GT-IEEE-Robotics/2018/Electrical/Bill Of Materials (what's on the robot so far) - Spreadsheet.xlsx

ITEM | COUNT | PRICE | LINK
base wheel motors | 4 | 39.95 | https://www.pololu.com/product/2824
distance sensors | 8 | 14.94 | https://www.adafruit.com/product/3317
motor controller |  |  | http://www.robotshop.com/en/cytron-10a-5-25v-dual-channel-dc-motor-driver.html#Supplier-Product-Code
