GT-IEEE-Robotics/2018/Electrical/Pi_ExternalConnections.xlsx

Interface | Link | Count | Section | Signal Name | Signal Description | Connector | Link
Pi Breakout Interface | Pi Pinout (https://pinout.xyz/) | 1 |  | N/A | Interface to Pi &Breakout | 40-pins (2 rows of 20) extra long female headers | adafruit (https://www.adafruit.com/product/1979)
Arduino Interface |  |  | power |  |  | 4-pin female latched 0.1" header | digikey (https://www.digikey.com/products/en?keywords=WM4826-ND) | https://www.digikey.com/products/en?keywords=WM4825-ND
 |  |  |  | GND | ground from arduino
 |  |  | serial | Tx | Pi's transmit
 |  |  |  | Rx | Pi's receive
Distance Sensor | adafruit (https://learn.adafruit.com/adafruit-vl53l0x-micro-lidar-distance-sensor-breakout/pinouts) | 8 |  | Vin | input voltage (use 3.3V for our logic levels) | 5-pin snapping connector | digikey (http://www.digikey.com/scripts/DkSearch/dksus.dll?Detail&itemSeq=252199103&uq=636543209955835002) | https://www.digikey.com/products/en?keywords=WM4827-ND
 |  |  |  | GND | ground
 |  |  |  | SHDN | Shutdown(pull low to shutdown)
 |  |  |  | SCL | i2c serial clock
 |  |  |  | SDA | i2c serial data
5V Power from Voltage Regulator |  |  | power | PWR_5V | 5V power from arduino | 2-pin female latched 0.1" header |  | https://www.digikey.com/products/en?keywords=WM4824-ND
 |  |  |  | GND | ground from arduino
