GT-IEEE-Robotics/2018/Electrical/Arduino_ExternalConnections.xlsx

Interface | Link | Count | Section | Signal Name | Signal Description | Connector | Link | Count
Arduino Due Shield Interface | due (https://store.arduino.cc/usa/arduino-due) | 1 |  |  |  | 8-pin extra long female headers | sparkfun (https://www.sparkfun.com/products/9279) | 5
 | pinout (http://www.robgray.com/temp/Due-pinout-WEB.png) |  |  |  |  | 10-pin " | sparkfun (https://www.sparkfun.com/products/11376) | 4
 |  |  |  |  |  | 2 row 3 pins (for SPI) | sparkfun (https://www.sparkfun.com/products/13010) | 1
 |  |  |  |  |  | 2 rows of 18 " (buy the 2 pack of 20 & cut) | sparkfun (https://www.sparkfun.com/products/14311) | 1
Battery Power |  | 1 |  | B_PWR | Battery Power (12V) | 2-pin 0.295" blade connector (rated to 18A) | digikey (https://www.digikey.com/product-detail/en/molex-llc/0431602102/WM18478-ND/300111)
 |  |  |  | B_GND | Battery Ground | *note: use 16-gauge wire(18 A)
Fuse(12V,30A) | digikey (https://www.digikey.com/product-detail/en/eaton/BK-AGC-30-R/283-2633-ND/954181) | 1 |  | from_battery |  | holder (use 2 of these) | digikey (https://www.digikey.com/product-detail/en/eaton/BK-1A1907-06-R/283-2601-ND/954119)
 |  |  |  | out_of_fuse
Pi Interface |  | 1 | power | PWR_5V | 5V to power the Pi (pin 2) | 4-pin female latched 0.1" header | digikey (https://www.digikey.com/products/en?keywords=WM4826-ND)
 |  |  |  | GND | Ground for Pi (pin 6)
 |  |  | serial | Rx | Arduino's Receive (connect to Pi's Tx)
 |  |  |  | Tx | Arduino's Transmit (connect to Pi's Rx)
Motor & Encoder | pololu (https://www.pololu.com/product/2824) | 6 |  | Red | Motor Power (from motor controller) | 6-pin female latched header | digikey (https://www.digikey.com/product-detail/en/molex-connector-corporation/0705430040/WM4828-ND/313743)
 |  |  |  | Black | Motor Ground (from motor controller)
 |  |  |  | Green | encoder ground
 |  |  |  | Blue | encoder power (5V)
 |  |  |  | Yellow | encoder out A
 |  |  |  | White | encoder out B
Dual-Motor Controller | robotshop (http://www.robotshop.com/en/cytron-10a-5-25v-dual-channel-dc-motor-driver.html) | 3 | control signals | M1 dir | motor 1 direction | 5-pin female header | (comes with)
 |  |  |  | M1 pwm | motor 1 speed
 |  |  |  | M2 dir | motor 2 direction
 |  |  |  | M2 pwm | motor 2 speed
 |  |  |  | GND | ground
 |  |  | power | M1B | motor 1 ground | .2" spaced pluggable terminal block | digikey (https://www.digikey.com/products/en?keywords=277-1110-ND)
 |  |  |  | M1A | motor 1 power | plug | digikey (https://www.digikey.com/product-detail/en/phoenix-contact/1757051/277-1015-ND/260383)
 |  |  |  | B+ | Battery Power (12V)
 |  |  |  | B- | Battery Ground
 |  |  |  | M2A | motor 2 power
 |  |  |  | M2B | motor 2 ground
Level Shifters | sparkfun (https://www.sparkfun.com/products/12009) | 3 | row 1 | HV1 | high voltage 1 | 6 pin 0.1" female header | digikey (https://www.digikey.com/product-detail/en/sullins-connector-solutions/PPTC061LFBN-RC/S7004-ND/810145)
 |  |  |  | HV2 | high voltage 2
 |  |  |  | HV | high voltage supply
 |  |  |  | GND | ground
 |  |  |  | HV3 | high voltage 3
 |  |  |  | HV4 | high voltage 4
 |  |  | row 2 | LV1 | low voltage 1 | 6 pin 0.1" female header | "
 |  |  |  | LV2 | low voltage 2
 |  |  |  | LV | low voltage supply
 |  |  |  | GND | ground
 |  |  |  | LV3 | low voltage 3
 |  |  |  | LV4 | low voltage 4
IMU | sparkfun (https://www.sparkfun.com/products/13284) | 1 | left | GND | ground | 0.1" standard header pins | digikey (https://www.digikey.com/products/en?mpart=PRPC040SACN-RC&v=35)
 |  |  |  | VDD/VCC | power (3.3V) | (only using this header)
 |  |  |  | SDA | i2c SDA OR SPI: MOSI
 |  |  |  | SCL | i2c & SPI serial clock
 |  |  | right | DEN | gyroscope data enable | 0.1" standard header pins | digikey (https://www.digikey.com/products/en?mpart=PRPC040SACN-RC&v=35)
 |  |  |  | INT1 | accel/gyro interrupt 1
 |  |  |  | INT2 | accel/gyro interrupt 2
 |  |  |  | INTM | magnetometer interrupt
 |  |  |  | RDY | magnetometer data ready
 |  |  |  | CS M | magnetometer chip select
 |  |  |  | CS AG | Accel/Gyro chip select
 |  |  |  | SDO M | SPI: Magnetometer MISO, I2C: Magnetometer Address Select
 |  |  |  | SDO AG | SPI: Accel/Gyro MISO, I2C: Accel/Gryo Address Select
