GT-IEEE-Robotics/2018/Electrical/MotorCape_hierchal/MotorCape.kicad_pcb

## KiCad design Electrical/MotorCape_hierchal/MotorCape.kicad_pcb (2018-04-20)

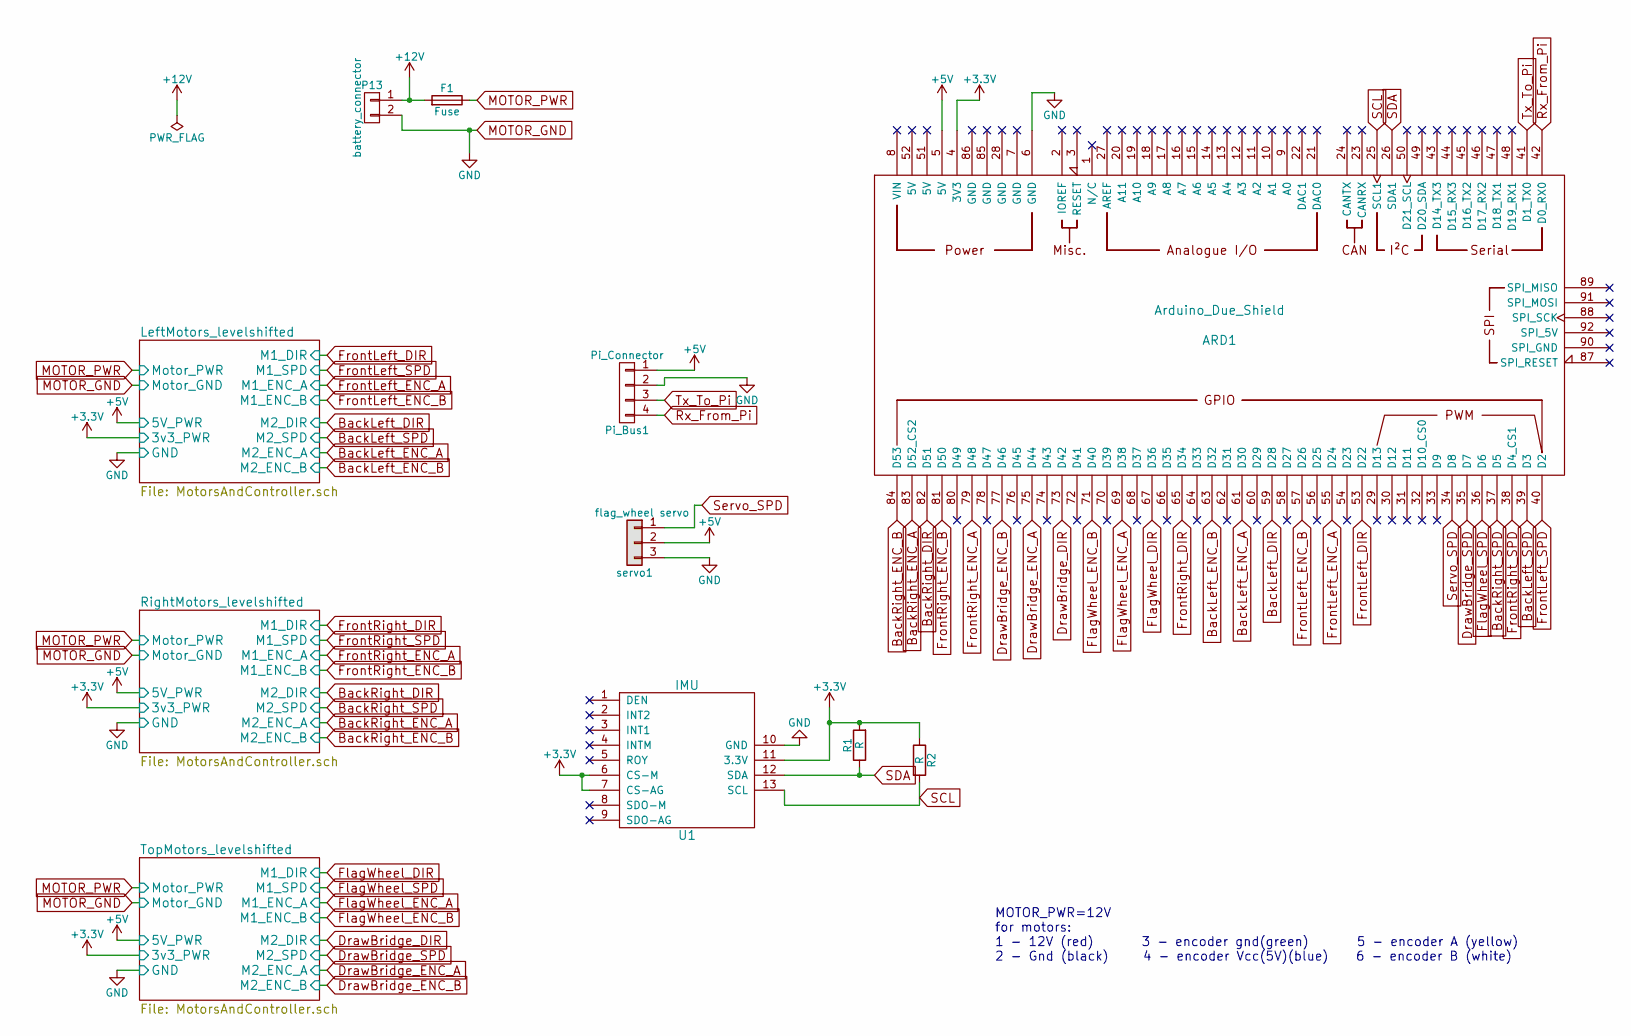
[picture p1: schematic MotorCape.sch]

Parts:
ARD1: Arduino_Due_Shield
F1: Fuse; Fuseholder_horizontal_inline_1_25x0_25_inch
P13: battery_connector; Molex_Sabre_43160-XX02_02x7.49mm_Vertical_BoardLock
Pi_Bus1: Pi_Connector; Pin_Header_Latched_1x04
R1, R2: R; R_Axial_DIN0204_L3.6mm_D1.6mm_P5.08mm_Horizontal
U1: IMU
servo1: flag_wheel servo; Pin_Header_Latched_1x03

Connections:
+3V3: ARD1.4 (3V3), R1.2, R2.1, U1.6 (CS-M), U1.7 (CS-AG), U1.11 (3.3V); also elsewhere on the board
+5V: ARD1.5 (5V), Pi_Bus1.1, servo1.2; also elsewhere on the board
+12V: F1.2, P13.1
BackLeft_DIR: ARD1.59 (D28); also elsewhere on the board
BackLeft_ENC_A: ARD1.61 (D30); also elsewhere on the board
BackLeft_ENC_B: ARD1.63 (D32); also elsewhere on the board
BackLeft_SPD: ARD1.39 (D3); also elsewhere on the board
BackRight_DIR: ARD1.82 (D51); also elsewhere on the board
BackRight_ENC_A: ARD1.83 (D52_CS2); also elsewhere on the board
BackRight_ENC_B: ARD1.84 (D53); also elsewhere on the board
BackRight_SPD: ARD1.37 (D5); also elsewhere on the board
DrawBridge_DIR: ARD1.73 (D42); also elsewhere on the board
DrawBridge_ENC_A: ARD1.75 (D44); also elsewhere on the board
DrawBridge_ENC_B: ARD1.77 (D46); also elsewhere on the board
DrawBridge_SPD: ARD1.35 (D7); also elsewhere on the board
FlagWheel_DIR: ARD1.67 (D36); also elsewhere on the board
FlagWheel_ENC_A: ARD1.69 (D38); also elsewhere on the board
FlagWheel_ENC_B: ARD1.71 (D40); also elsewhere on the board
FlagWheel_SPD: ARD1.36 (D6); also elsewhere on the board
FrontLeft_DIR: ARD1.53 (D22); also elsewhere on the board
FrontLeft_ENC_A: ARD1.55 (D24); also elsewhere on the board
FrontLeft_ENC_B: ARD1.57 (D26); also elsewhere on the board
FrontLeft_SPD: ARD1.40 (D2); also elsewhere on the board
FrontRight_DIR: ARD1.65 (D34); also elsewhere on the board
FrontRight_ENC_A: ARD1.79 (D48); also elsewhere on the board
FrontRight_ENC_B: ARD1.81 (D50); also elsewhere on the board
FrontRight_SPD: ARD1.38 (D4_CS1); also elsewhere on the board
MOTOR_GND: ARD1.6 (GND), P13.2, Pi_Bus1.2, U1.10 (GND), servo1.3; also elsewhere on the board
MOTOR_PWR: F1.1; also elsewhere on the board
Rx_From_Pi: ARD1.42 (D0_RX0), Pi_Bus1.4
SCL: ARD1.25 (SCL1), R2.2, U1.13 (SCL)
SDA: ARD1.26 (SDA1), R1.1, U1.12 (SDA)
Servo_SPD: ARD1.34 (D8), servo1.1
Tx_To_Pi: ARD1.41 (D1_TX0), Pi_Bus1.3

Notes on the sheet:
MOTOR_PWR=12V for motors: 1 - 12V (red) 3 - encoder gnd(green) 5 - encoder A (yellow) 2 - Gnd (black) 4 - encoder Vcc(5V)(blue) 6 - encoder B (white)

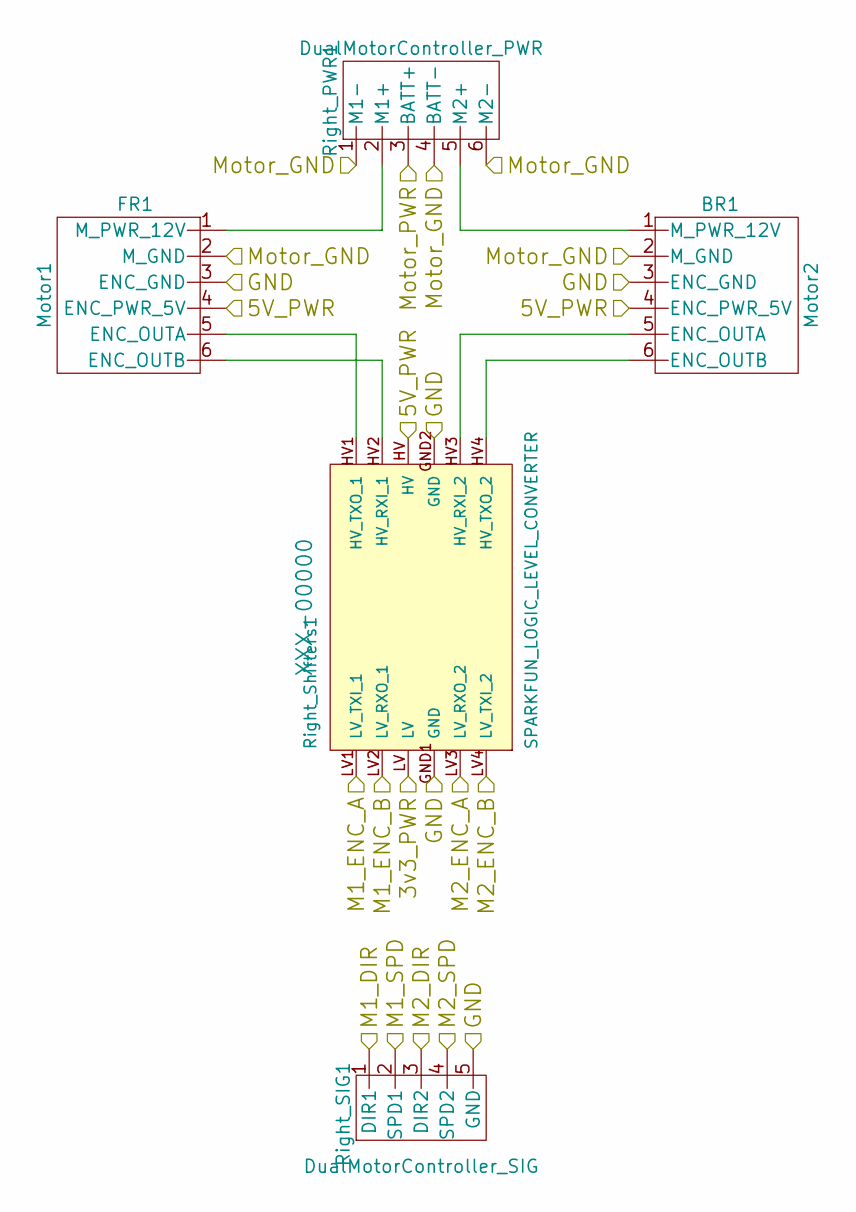
[picture p2: schematic MotorsAndController.sch]

Parts:
BL1: Motor2; Pin_Header_Latched_1x06
FL1: Motor1; Pin_Header_Latched_1x06
Left_PWR1: DualMotorController_PWR; PhoenixContact_MSTBA-G_06x5.08mm_Angled
Left_SIG1: DualMotorController_SIG; Pin_Header_Latched_1x05
Left_Shifters1: SPARKFUN_LOGIC_LEVEL_CONVERTER

Connections:
+3V3: Left_Shifters1.LV; also elsewhere on the board
+5V: BL1.4 (ENC_PWR_5V), FL1.4 (ENC_PWR_5V), Left_Shifters1.HV; also elsewhere on the board
BackLeft_DIR: Left_SIG1.3 (DIR2); also elsewhere on the board
BackLeft_ENC_A: Left_Shifters1.LV3 (LV_RXO_2); also elsewhere on the board
BackLeft_ENC_B: Left_Shifters1.LV4 (LV_TXI_2); also elsewhere on the board
BackLeft_SPD: Left_SIG1.4 (SPD2); also elsewhere on the board
FrontLeft_DIR: Left_SIG1.1 (DIR1); also elsewhere on the board
FrontLeft_ENC_A: Left_Shifters1.LV1 (LV_TXI_1); also elsewhere on the board
FrontLeft_ENC_B: Left_Shifters1.LV2 (LV_RXO_1); also elsewhere on the board
FrontLeft_SPD: Left_SIG1.2 (SPD1); also elsewhere on the board
MOTOR_GND: BL1.2 (M_GND), BL1.3 (ENC_GND), FL1.2 (M_GND), FL1.3 (ENC_GND), Left_PWR1.1 (M1-), Left_PWR1.4 (BATT-), Left_PWR1.6 (M2-), Left_SIG1.5 (GND), Left_Shifters1.GND1 (GND), Left_Shifters1.GND2 (GND); also elsewhere on the board
MOTOR_PWR: Left_PWR1.3 (BATT+); also elsewhere on the board
unnamed: BL1.1 (M_PWR_12V), Left_PWR1.5 (M2+)
unnamed: BL1.5 (ENC_OUTA), Left_Shifters1.HV3 (HV_RXI_2)
unnamed: BL1.6 (ENC_OUTB), Left_Shifters1.HV4 (HV_TXO_2)
unnamed: FL1.1 (M_PWR_12V), Left_PWR1.2 (M1+)
unnamed: FL1.5 (ENC_OUTA), Left_Shifters1.HV1 (HV_TXO_1)
unnamed: FL1.6 (ENC_OUTB), Left_Shifters1.HV2 (HV_RXI_1)

Parts of its further copies:
BR1: Motor2; Pin_Header_Latched_1x06
DrawBridge1: Motor2; Pin_Header_Latched_1x06
FR1: Motor1; Pin_Header_Latched_1x06
FlagWheel1: Motor1; Pin_Header_Latched_1x06
Right_PWR1: DualMotorController_PWR; PhoenixContact_MSTBA-G_06x5.08mm_Angled
Right_SIG1: DualMotorController_SIG; Pin_Header_Latched_1x05
Right_Shifters1: SPARKFUN_LOGIC_LEVEL_CONVERTER
Top_PWR1: DualMotorController_PWR; PhoenixContact_MSTBA-G_06x5.08mm_Angled
Top_SIG1: DualMotorController_SIG; Pin_Header_Latched_1x05
Top_Shifters1: SPARKFUN_LOGIC_LEVEL_CONVERTER

Connections of its further copies:
+3V3: Right_Shifters1.LV, Top_Shifters1.LV; also elsewhere on the board
+5V: BR1.4 (ENC_PWR_5V), DrawBridge1.4 (ENC_PWR_5V), FR1.4 (ENC_PWR_5V), FlagWheel1.4 (ENC_PWR_5V), Right_Shifters1.HV, Top_Shifters1.HV; also elsewhere on the board
BackRight_DIR: Right_SIG1.3 (DIR2); also elsewhere on the board
BackRight_ENC_A: Right_Shifters1.LV3 (LV_RXO_2); also elsewhere on the board
BackRight_ENC_B: Right_Shifters1.LV4 (LV_TXI_2); also elsewhere on the board
BackRight_SPD: Right_SIG1.4 (SPD2); also elsewhere on the board
DrawBridge_DIR: Top_SIG1.3 (DIR2); also elsewhere on the board
DrawBridge_ENC_A: Top_Shifters1.LV3 (LV_RXO_2); also elsewhere on the board
DrawBridge_ENC_B: Top_Shifters1.LV4 (LV_TXI_2); also elsewhere on the board
DrawBridge_SPD: Top_SIG1.4 (SPD2); also elsewhere on the board
FlagWheel_DIR: Top_SIG1.1 (DIR1); also elsewhere on the board
FlagWheel_ENC_A: Top_Shifters1.LV1 (LV_TXI_1); also elsewhere on the board
FlagWheel_ENC_B: Top_Shifters1.LV2 (LV_RXO_1); also elsewhere on the board
FlagWheel_SPD: Top_SIG1.2 (SPD1); also elsewhere on the board
FrontRight_DIR: Right_SIG1.1 (DIR1); also elsewhere on the board
FrontRight_ENC_A: Right_Shifters1.LV1 (LV_TXI_1); also elsewhere on the board
FrontRight_ENC_B: Right_Shifters1.LV2 (LV_RXO_1); also elsewhere on the board
FrontRight_SPD: Right_SIG1.2 (SPD1); also elsewhere on the board
MOTOR_GND: BR1.2 (M_GND), BR1.3 (ENC_GND), DrawBridge1.2 (M_GND), DrawBridge1.3 (ENC_GND), FR1.2 (M_GND), FR1.3 (ENC_GND), FlagWheel1.2 (M_GND), FlagWheel1.3 (ENC_GND), Right_PWR1.1 (M1-), Right_PWR1.4 (BATT-), Right_PWR1.6 (M2-), Right_SIG1.5 (GND), Right_Shifters1.GND1 (GND), Right_Shifters1.GND2 (GND), Top_PWR1.1 (M1-), Top_PWR1.4 (BATT-), Top_PWR1.6 (M2-), Top_SIG1.5 (GND), Top_Shifters1.GND1 (GND), Top_Shifters1.GND2 (GND); also elsewhere on the board
MOTOR_PWR: Right_PWR1.3 (BATT+), Top_PWR1.3 (BATT+); also elsewhere on the board
unnamed: BR1.1 (M_PWR_12V), Right_PWR1.5 (M2+)
unnamed: BR1.5 (ENC_OUTA), Right_Shifters1.HV3 (HV_RXI_2)
unnamed: BR1.6 (ENC_OUTB), Right_Shifters1.HV4 (HV_TXO_2)
unnamed: DrawBridge1.1 (M_PWR_12V), Top_PWR1.5 (M2+)
unnamed: DrawBridge1.5 (ENC_OUTA), Top_Shifters1.HV3 (HV_RXI_2)
unnamed: DrawBridge1.6 (ENC_OUTB), Top_Shifters1.HV4 (HV_TXO_2)
unnamed: FR1.1 (M_PWR_12V), Right_PWR1.2 (M1+)
unnamed: FR1.5 (ENC_OUTA), Right_Shifters1.HV1 (HV_TXO_1)
unnamed: FR1.6 (ENC_OUTB), Right_Shifters1.HV2 (HV_RXI_1)
unnamed: FlagWheel1.1 (M_PWR_12V), Top_PWR1.2 (M1+)
unnamed: FlagWheel1.5 (ENC_OUTA), Top_Shifters1.HV1 (HV_TXO_1)
unnamed: FlagWheel1.6 (ENC_OUTB), Top_Shifters1.HV2 (HV_RXI_1)

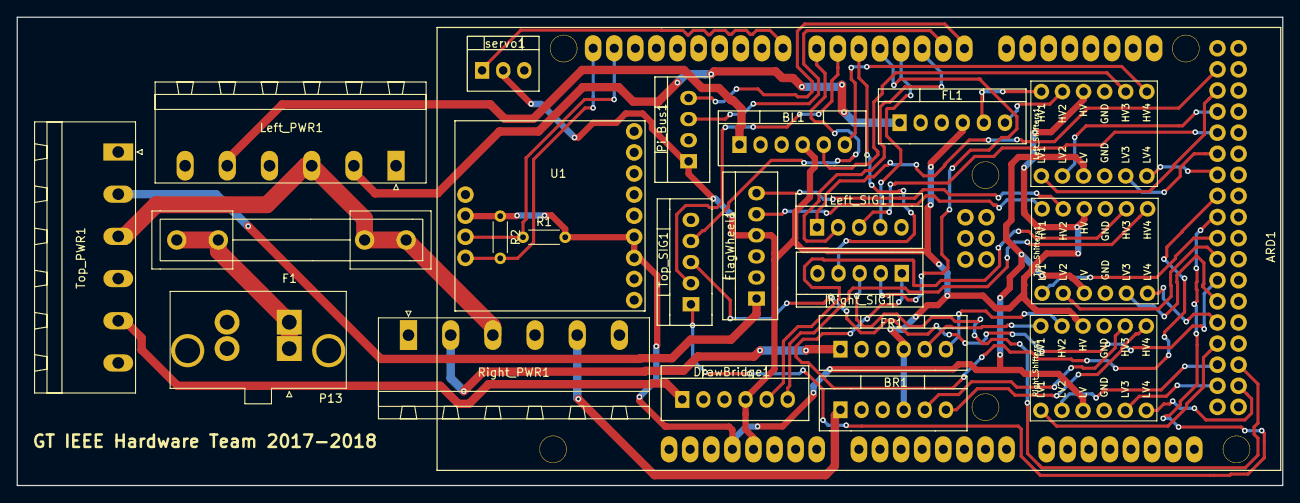
[picture p3: board Electrical/MotorCape_hierchal/MotorCape.kicad_pcb from above]

Board: 2 copper layers, 152.4 x 56.4 mm, 23 parts (0 on the bottom side), 52 nets.
