GT-IEEE-Robotics/2018/Electrical/Pi Cape/PI_Cape.kicad_pcb

## KiCad design Electrical/Pi Cape/PI_Cape.kicad_pcb (2018-04-20)

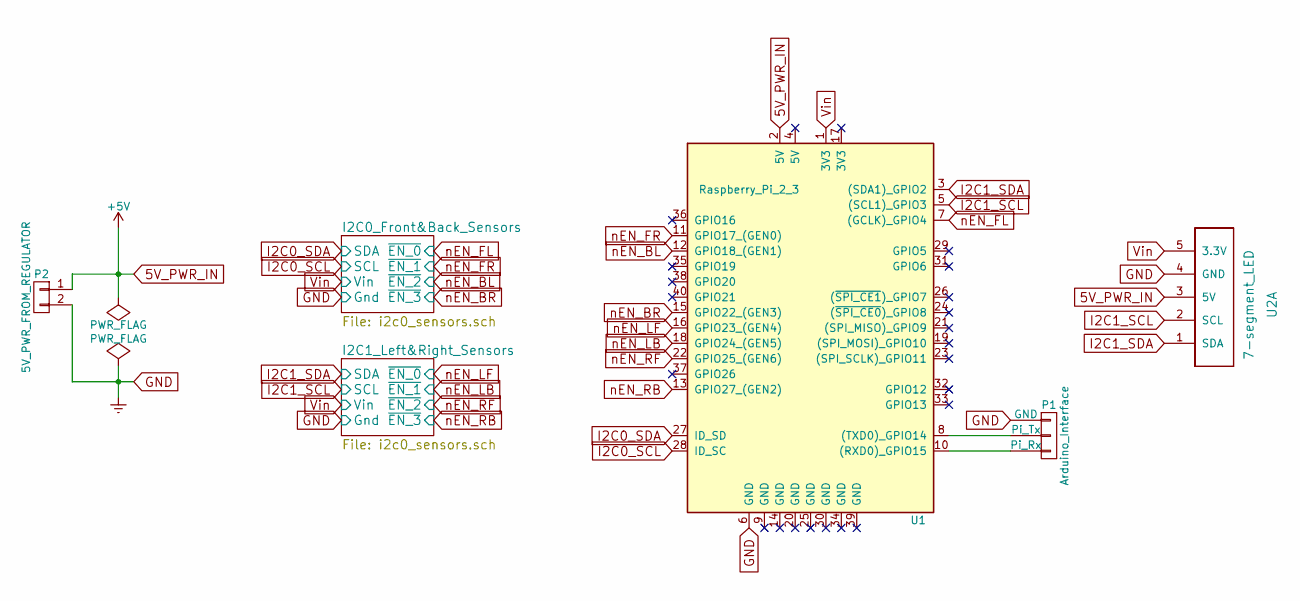
[picture p4: schematic PI_Cape.sch]

Parts:
P1: Arduino_Interface; Pin_Header_Latched_1x03
P2: 5V_PWR_FROM_REGULATOR; Pin_Header_Latched_1x02
U1: Raspberry_Pi_2_3; Pin_Header_Straight_2x20
U2: 7-segment_LED; Pin_Header_Straight_1x05

Connections:
5V_PWR_IN: P2.1, U1.2 (5V), U2.3 (5V)
GND: P1.1 (GND), P2.2, U1.6 (GND), U2.4 (GND); also elsewhere on the board
I2C0_SCL: U1.28 (ID_SC); also elsewhere on the board
I2C0_SDA: U1.27 (ID_SD); also elsewhere on the board
I2C1_SCL: U1.5 ((SCL1)_GPIO3), U2.2 (SCL); also elsewhere on the board
I2C1_SDA: U1.3 ((SDA1)_GPIO2), U2.1 (SDA); also elsewhere on the board
unnamed: P1.2 (Pi_Tx), U1.8 ((TXD0)_GPIO14)
unnamed: P1.3 (Pi_Rx), U1.10 ((RXD0)_GPIO15)
Vin: U1.1 (3V3), U2.5 (3.3V); also elsewhere on the board
nEN_BL: U1.12 (GPIO18_(GEN1)); also elsewhere on the board
nEN_BR: U1.15 (GPIO22_(GEN3)); also elsewhere on the board
nEN_FL: U1.7 ((GCLK)_GPIO4); also elsewhere on the board
nEN_FR: U1.11 (GPIO17_(GEN0)); also elsewhere on the board
nEN_LB: U1.18 (GPIO24_(GEN5)); also elsewhere on the board
nEN_LF: U1.16 (GPIO23_(GEN4)); also elsewhere on the board
nEN_RB: U1.13 (GPIO27_(GEN2)); also elsewhere on the board
nEN_RF: U1.22 (GPIO25_(GEN6)); also elsewhere on the board

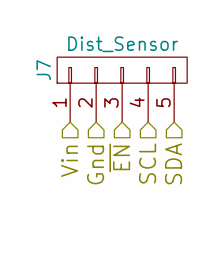
[picture p5: schematic i2c0.sch]

Parts:
J1: Dist_Sensor; Pin_Header_Latched_1x05

Connections:
GND: J1.2; also elsewhere on the board
I2C0_SCL: J1.4; also elsewhere on the board
I2C0_SDA: J1.5; also elsewhere on the board
Vin: J1.1; also elsewhere on the board
nEN_FL: J1.3; also elsewhere on the board

Parts of its further copies:
J2, J3, J4, J5, J6, J7, J8: Dist_Sensor; Pin_Header_Latched_1x05

Connections of its further copies:
GND: J2.2, J3.2, J4.2, J5.2, J6.2, J7.2, J8.2; also elsewhere on the board
I2C0_SCL: J2.4, J3.4, J4.4; also elsewhere on the board
I2C0_SDA: J2.5, J3.5, J4.5; also elsewhere on the board
I2C1_SCL: J5.4, J6.4, J7.4, J8.4; also elsewhere on the board
I2C1_SDA: J5.5, J6.5, J7.5, J8.5; also elsewhere on the board
Vin: J2.1, J3.1, J4.1, J5.1, J6.1, J7.1, J8.1; also elsewhere on the board
nEN_BL: J3.3; also elsewhere on the board
nEN_BR: J4.3; also elsewhere on the board
nEN_FR: J2.3; also elsewhere on the board
nEN_LB: J6.3; also elsewhere on the board
nEN_LF: J5.3; also elsewhere on the board
nEN_RB: J8.3; also elsewhere on the board
nEN_RF: J7.3; also elsewhere on the board

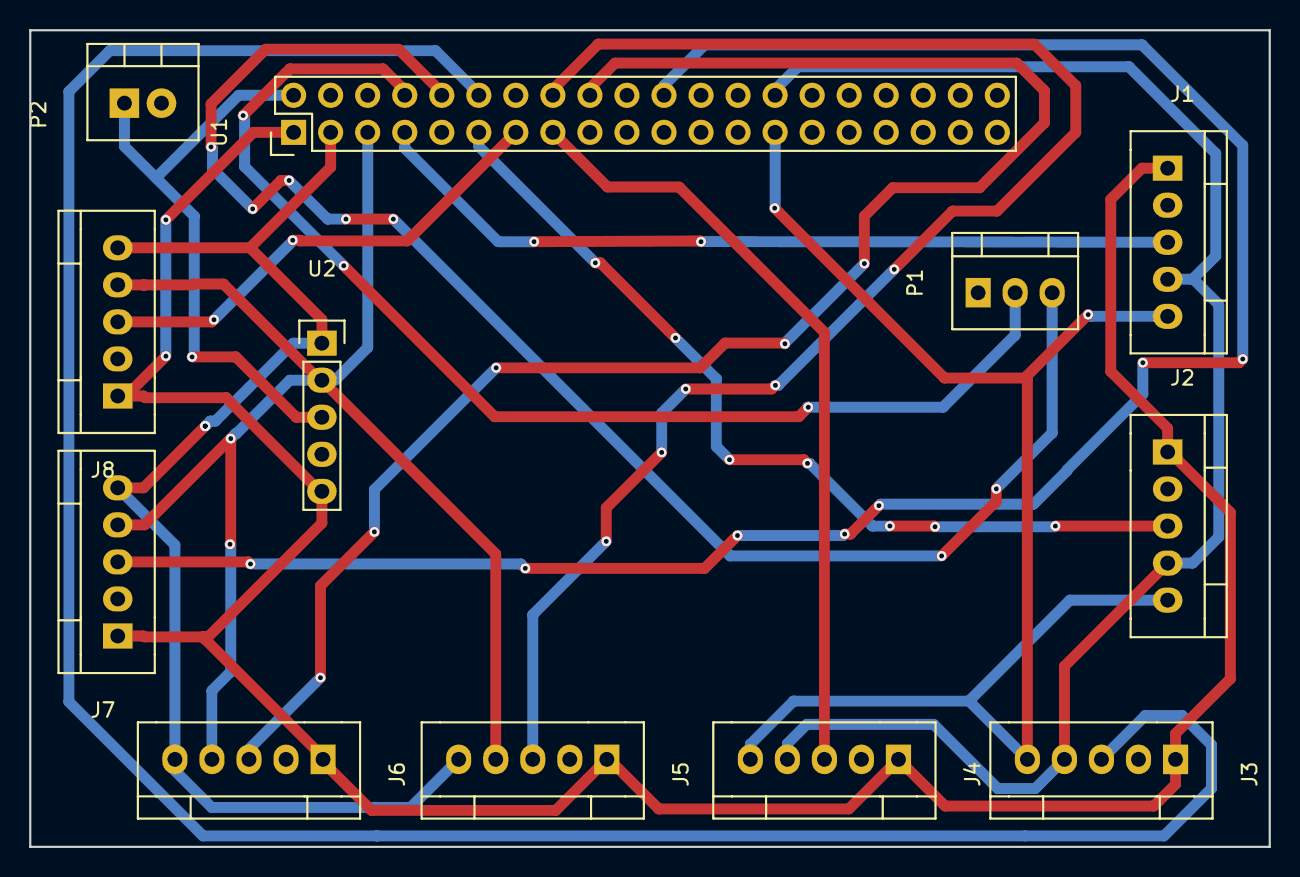
[picture p6: board PI_Cape.kicad_pcb from above]

Board: 2 copper layers, 85.0 x 56.0 mm, 12 parts (0 on the bottom side), 17 nets.
