GT-IEEE-Robotics/2018/Electrical/Motor Cape/MotorCape.kicad_pcb

## KiCad design Electrical/Motor Cape/MotorCape.kicad_pcb (2018-04-10)

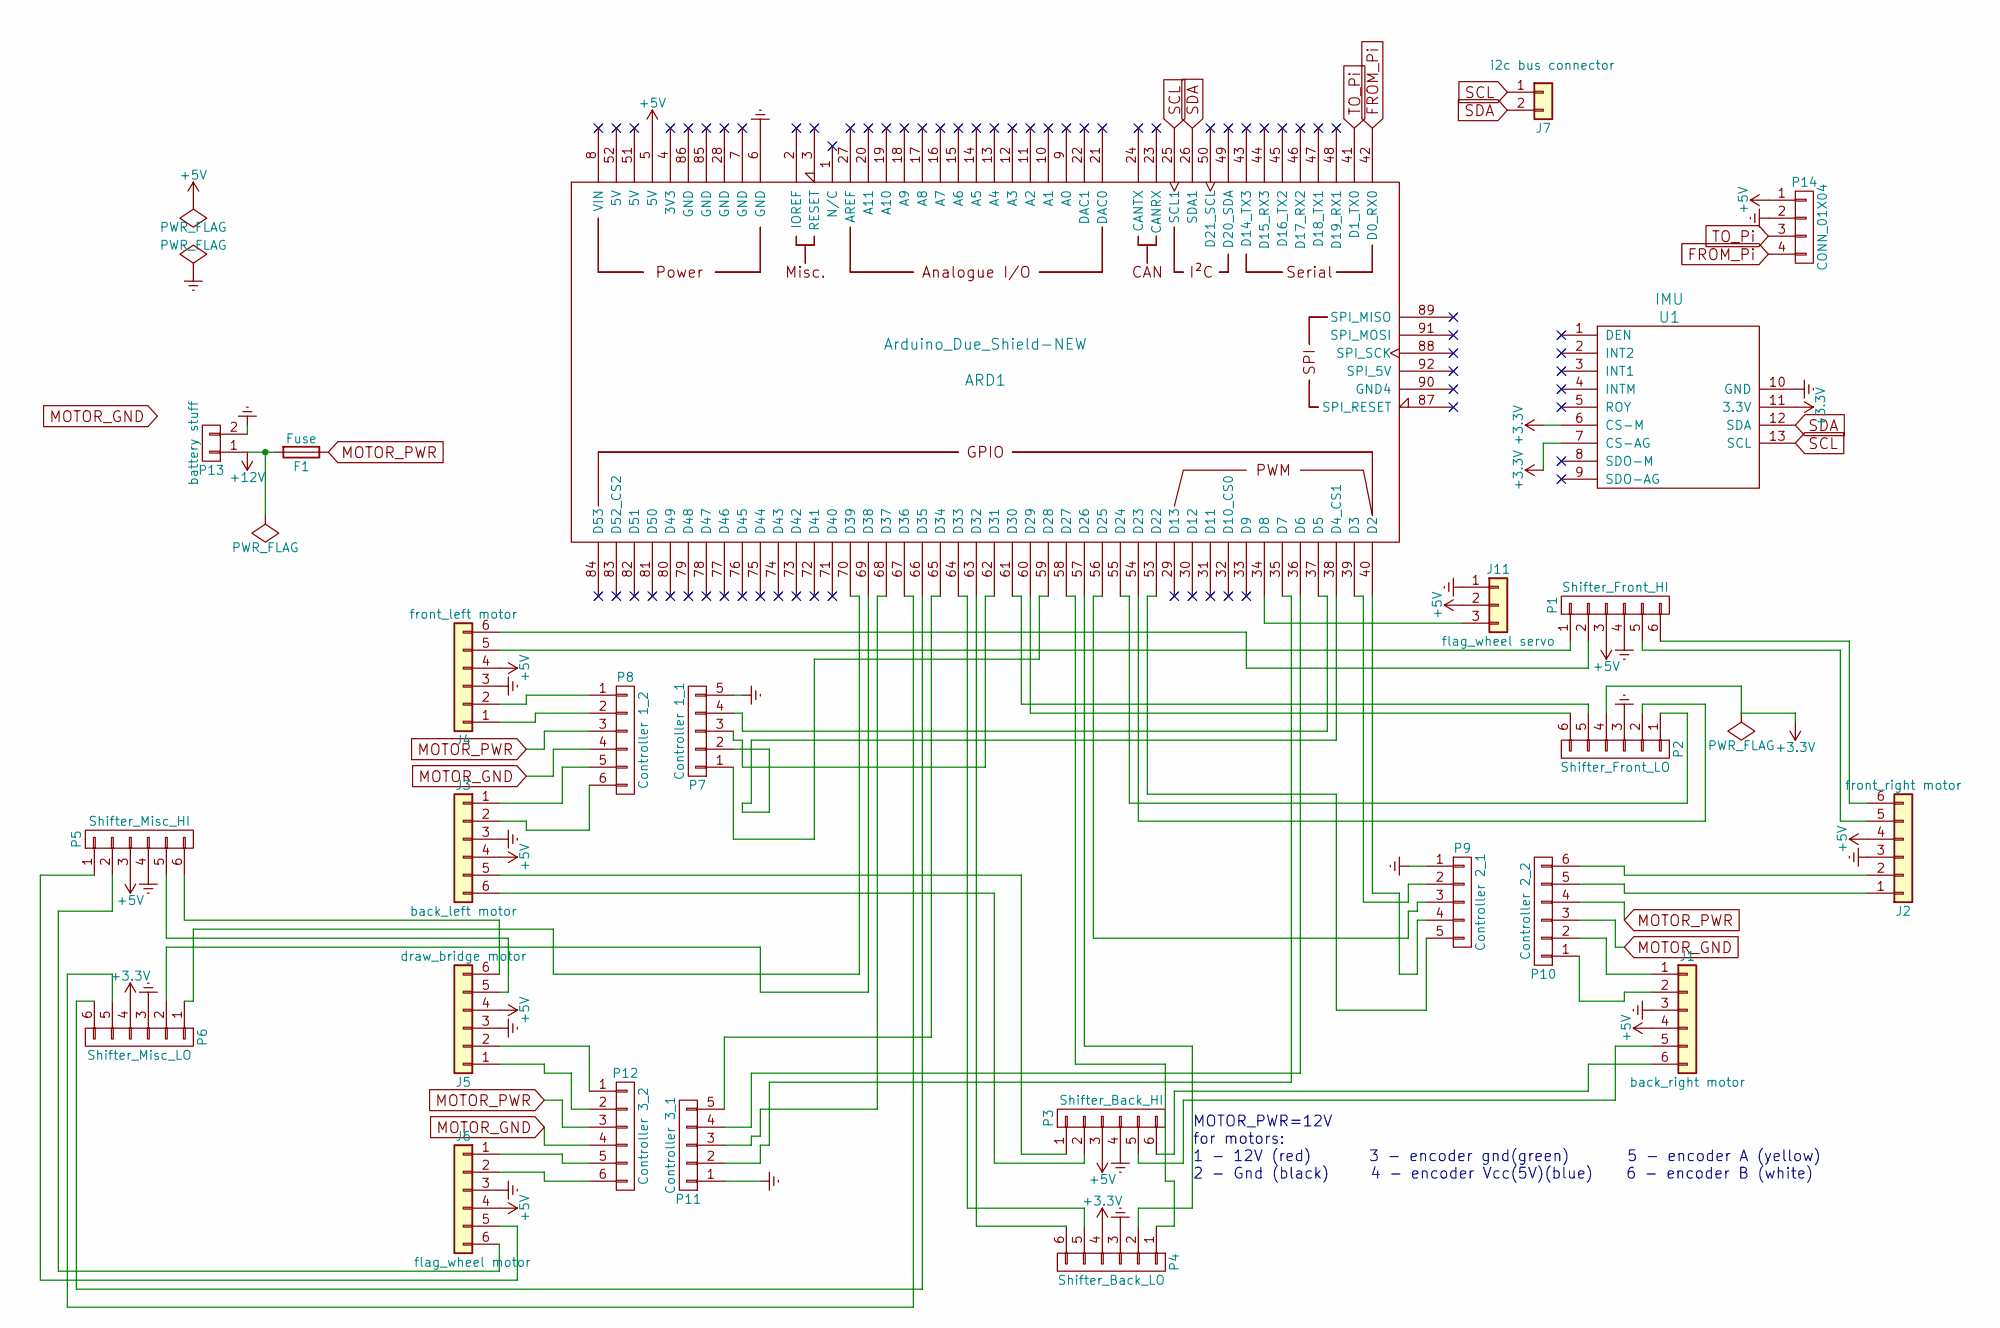
[picture p7: schematic MotorCape.sch]

Parts:
ARD1: Arduino_Due_Shield-NEW; Arduino_Due_Shield
F1: Fuse; Fuseholder5x20_horiz_open_inline_Type-I
J1: back_right motor; Pin_Header_Straight_1x06
J2: front_right motor; Pin_Header_Straight_1x06
J3: back_left motor; Pin_Header_Straight_1x06
J4: front_left motor; Pin_Header_Straight_1x06
J5: draw_bridge motor; Pin_Header_Straight_1x06
J6: flag_wheel motor; Pin_Header_Straight_1x06
J7: i2c bus connector; Pin_Header_Straight_1x02
J11: flag_wheel servo; Pin_Header_Straight_1x03
P1: Shifter_Front_HI; Pin_Header_Straight_1x06
P2: Shifter_Front_LO; Pin_Header_Straight_1x06
P3: Shifter_Back_HI; Pin_Header_Straight_1x06
P4: Shifter_Back_LO; Pin_Header_Straight_1x06
P5: Shifter_Misc_HI; Pin_Header_Straight_1x06
P6: Shifter_Misc_LO; Pin_Header_Straight_1x06
P7: Controller 1_1; Pin_Header_Straight_1x05
P8: Controller 1_2; TerminalBlock_Pheonix_MPT-2.54mm_6pol
P9: Controller 2_1; Pin_Header_Straight_1x05
P10: Controller 2_2; TerminalBlock_Pheonix_MPT-2.54mm_6pol
P11: Controller 3_1; Pin_Header_Straight_1x05
P12: Controller 3_2; TerminalBlock_Pheonix_MPT-2.54mm_6pol
P13: battery stuff; Pin_Header_Straight_1x02
P14: CONN_01X04; Pin_Header_Straight_1x04
U1: IMU

Connections:
+3V3: P2.4, P4.4, P6.4, U1.6 (CS-M), U1.7 (CS-AG), U1.11 (3.3V)
+5V: ARD1.5 (5V), J1.4, J2.4, J3.4, J4.4, J5.4, J6.4, J11.2, P1.3, P3.3, P5.3, P14.1
+12V: F1.2, P13.1
Earth: ARD1.6 (GND), J1.3, J2.3, J3.3, J4.3, J5.3, J6.3, J11.1, P1.4, P2.3, P3.4, P4.3, P5.4, P6.3, P7.5, P9.1, P11.1, P13.2, P14.2, U1.10 (GND)
FROM_Pi: ARD1.42 (D0_RX0), P14.4
MOTOR_GND: P8.4, P10.3, P12.4
MOTOR_PWR: F1.1, P8.3, P10.4, P12.3
unnamed: ARD1.34 (D8), J11.3
unnamed: ARD1.35 (D7), P11.2
unnamed: ARD1.36 (D6), P11.4
unnamed: ARD1.37 (D5), P7.4
unnamed: ARD1.38 (D4_CS1), P7.2
unnamed: ARD1.39 (D3), P9.2
unnamed: ARD1.40 (D2), P9.4
unnamed: ARD1.53 (D22), P9.5
unnamed: ARD1.54 (D23), P2.2
unnamed: ARD1.55 (D24), P2.1
unnamed: ARD1.56 (D25), P9.3
unnamed: ARD1.57 (D26), P4.2
unnamed: ARD1.58 (D27), P4.1
unnamed: ARD1.59 (D28), P7.1
unnamed: ARD1.60 (D29), P2.6
unnamed: ARD1.61 (D30), P2.5
unnamed: ARD1.62 (D31), P7.3
unnamed: ARD1.63 (D32), P4.6
unnamed: ARD1.64 (D33), P4.5
unnamed: ARD1.65 (D34), P11.5
unnamed: ARD1.66 (D35), P6.6
unnamed: ARD1.67 (D36), P6.5
unnamed: ARD1.68 (D37), P11.3
unnamed: ARD1.69 (D38), P6.2
unnamed: ARD1.70 (D39), P6.1
unnamed: J1.1, P10.2
unnamed: J1.2, P10.1
unnamed: J1.5, P3.5
unnamed: J1.6, P3.6
unnamed: J2.1, P10.5
unnamed: J2.2, P10.6
unnamed: J2.5, P1.5
unnamed: J2.6, P1.6
unnamed: J3.1, P8.5
unnamed: J3.2, P8.6
unnamed: J3.5, P3.1
unnamed: J3.6, P3.2
unnamed: J4.1, P8.2
unnamed: J4.2, P8.1
unnamed: J4.5, P1.1
unnamed: J4.6, P1.2
unnamed: J5.1, P12.2
unnamed: J5.2, P12.1
unnamed: J5.5, P5.5
unnamed: J5.6, P5.6
unnamed: J6.1, P12.5
unnamed: J6.2, P12.6
unnamed: J6.5, P5.1
unnamed: J6.6, P5.2
SCL: ARD1.25 (SCL1), J7.1, U1.13 (SCL)
SDA: ARD1.26 (SDA1), J7.2, U1.12 (SDA)
TO_Pi: ARD1.41 (D1_TX0), P14.3

Notes on the sheet:
MOTOR_PWR=12V for motors: 1 - 12V (red) 3 - encoder gnd(green) 5 - encoder A (yellow) 2 - Gnd (black) 4 - encoder Vcc(5V)(blue) 6 - encoder B (white)

Board: 2 copper layers, 25 parts (0 on the bottom side), 59 nets, no tracks yet.
