GT-IEEE-Robotics/2018/OnThePi/VL53L0X_rasp_python/python/sensorBus0.py

#!/usr/bin/python

# MIT License
# 
# Copyright (c) 2017 John Bryan Moore
# 
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
import time
import VL53L0X
import RPi.GPIO as GPIO



def initBus0():
    # GPIO for Sensor 1 shutdown pin
    sensor1_shutdown = 20
    # GPIO for sensor 3 shutdown pin
    sensor2_shutdown = 26
    # GPIO for Sensor 6 shutdown pin
    sensor3_shutdown = 13
    # GPIO for sensor 8 shutdown pin
    sensor4_shutdown = 6


    GPIO.setwarnings(False)

    # Setup GPIO for shutdown pins on each VL53L0X
    GPIO.setmode(GPIO.BCM)
    GPIO.setup(sensor1_shutdown, GPIO.OUT)
    GPIO.setup(sensor2_shutdown, GPIO.OUT)
    GPIO.setup(sensor3_shutdown, GPIO.OUT)
    GPIO.setup(sensor4_shutdown, GPIO.OUT)


    # Set all shutdown pins low to turn off each VL53L0X
    GPIO.output(sensor1_shutdown, GPIO.LOW)
    GPIO.output(sensor2_shutdown, GPIO.LOW)
    GPIO.output(sensor3_shutdown, GPIO.LOW)
    GPIO.output(sensor4_shutdown, GPIO.LOW)

    # Keep all low for 500 ms or so to make sure they reset
    time.sleep(0.50)

    # Create one object per VL53L0X passing the address to give to
    # each.
    tof1 = VL53L0X.VL53L0X(address=0x20)
    tof2 = VL53L0X.VL53L0X(address=0x21)
    tof3 = VL53L0X.VL53L0X(address=0x22)
    tof4 = VL53L0X.VL53L0X(address=0x23)


    # Set shutdown pin high for the first VL53L0X then 
    # call to start ranging 
    GPIO.output(sensor1_shutdown, GPIO.HIGH)
    time.sleep(0.50)
    tof1.start_ranging(VL53L0X.VL53L0X_BEST_ACCURACY_MODE)

    # Set shutdown pin high for the first VL53L0X then 
    # call to start ranging 
    GPIO.output(sensor2_shutdown, GPIO.HIGH)
    time.sleep(0.50)
    tof2.start_ranging(VL53L0X.VL53L0X_BEST_ACCURACY_MODE)

    # Set shutdown pin high for the first VL53L0X then 
    # call to start ranging 
    GPIO.output(sensor3_shutdown, GPIO.HIGH)
    time.sleep(0.50)
    tof3.start_ranging(VL53L0X.VL53L0X_BEST_ACCURACY_MODE)

    # Set shutdown pin high for the first VL53L0X then 
    # call to start ranging 
    GPIO.output(sensor4_shutdown, GPIO.HIGH)
    time.sleep(0.50)
    tof4.start_ranging(VL53L0X.VL53L0X_BEST_ACCURACY_MODE)

    timing = tof1.get_timing()
    if (timing < 20000):
        timing = 20000
    #print ("Timing %d ms" % (timing/1000))


    return [tof1, tof2, tof3, tof4]

def stopBus0(gpio_arr):
    tof1.stop_ranging()
    GPIO.output(sensor1_shutdown, GPIO.LOW)
    tof2.stop_ranging()
    GPIO.output(sensor2_shutdown, GPIO.LOW)
    tof3.stop_ranging()
    GPIO.output(sensor3_shutdown, GPIO.LOW)
    tof4.stop_ranging()
    GPIO.output(sensor4_shutdown, GPIO.LOW)

def readBus0(gpio_arr):
    global tof1
    global tof2
    global tof3
    global tof4
    distances = [0,0,0,0]
    distances[0] = tof1.get_distance()
    distances[1] = tof2.get_distance()
    distances[2] = tof3.get_distance()
    distances[3] = tof4.get_distance()
    time.sleep(timing/1000000)
    return distances


 
