GT-IEEE-Robotics/2018/Motor Controller/SimpleMC/SimpleMC.ino

#include "Motor.h"

/* Function prototypes */
void driveForward(int);
void driveBackward(int);
void driveLeft(int);
void driveRight(int);
void robotBrake();
/* * * * * * * * * * * */

Motor motor1 = Motor(2, 24, 25, 22);
Motor motor2 = Motor(3, 26, 27, 22);
Motor motor3 = Motor(4, 28, 29, 22);
Motor motor4 = Motor(5, 30, 31, 22);

void setup() {
  Serial.begin(9600);
  Serial.println("Program starting...");
}

void loop() {
  driveForward(255);
  delay(5000);
  robotBrake();
  delay(3000);
  driveLeft(255);
  delay(5000);
  robotBrake();
  delay(3000);
  driveBackward(255);
  delay(5000);
  robotBrake();
  delay(3000);
  driveRight(255);
  delay(5000);
  robotBrake();
  delay(3000);
  while (true) delay(1000); // stop loop for now
}

void driveForward(int x) {
  motor1.drive(x, 1);
  motor2.drive(x, 0);
}

void driveBackward(int x) {
  motor1.drive(x, 0);
  motor2.drive(x, 1);
}

void driveLeft(int x) {
  motor1.drive(x, 0);
  motor2.drive(x, 0);
}

void driveRight(int x) {
  motor1.drive(x, 1);
  motor2.drive(x, 1);
}

void robotBrake() {
  motor1.brake();
  motor2.brake();
}
