GT-IEEE-Robotics/2018/OnThePi/VL53L0X_rasp_python/python/example_particle_filter.py

import matplotlib.pyplot as plt
from filterpy.monte_carlo import systematic_resample
from numpy.linalg import norm
from numpy.random import randn
import scipy.stats

from numpy.random import uniform


import matplotlib.pyplot as plt
import numpy as np
from numpy.random import uniform

from sensorBus import *
import time

delay = .5

gpio0_arr = [20, 26, 13, 6]
gpio1_arr = [12, 16, 19, 21]

addr_arr_bus0 = [0x20,0x21,0x22,0x23]
addr_arr_bus1 = [0x24,0x25,0x26,0x27]

tof_arr0 = initBus(0, gpio0_arr, addr_arr_bus0)
tof_arr1 = initBus(1, gpio1_arr, addr_arr_bus1)

def getSensorReadings():
    oneBus = readBus(tof_arr1)
    time.sleep(delay)

    zeroBus = readBus(tof_arr0)
    time.sleep(delay)
    np.concatenate(zeroBus, oneBus)

def getHeading():
    

def estimate(particles, weights):
    """returns mean and variance of the weighted particles"""

    pos = particles[:, 0:2]
    mean = np.average(pos, weights=weights, axis=0)
    var  = np.average((pos - mean)**2, weights=weights, axis=0)
    return mean, var

def resample_from_index(particles, weights, indexes):
    particles[:] = particles[indexes]
    weights[:] = weights[indexes]
    weights.fill (1.0 / len(weights))

def neff(weights):
    return 1. / np.sum(np.square(weights))

def predict(particles, u, std, dt=1.):
    """ move according to control input u (heading change, velocity)
    with noise Q (std heading change, std velocity)`"""

    N = len(particles)
    # update heading
    particles[:, 2] += u[0] + (randn(N) * std[0])
    particles[:, 2] %= 2 * np.pi

    # move in the (noisy) commanded direction
    dist = getSensorReadings()
    particles[:, 0] += np.cos(particles[:, 2]) * dist
    particles[:, 1] += np.sin(particles[:, 2]) * dist

def update(particles, weights, z, R, landmarks):
    weights.fill(1.)
    for i, landmark in enumerate(landmarks):
        distance = np.linalg.norm(particles[:, 0:2] - landmark, axis=1)
        weights *= scipy.stats.norm(distance, R).pdf(z[i])

    weights += 1.e-300      # avoid round-off to zero
    weights /= sum(weights) # normalize

N = 20000  # number of points
radius = 1
area = (2*radius)**2

pts = uniform(-1, 1, (N, 2))

# distance from (0,0)
dist = np.linalg.norm(pts, axis=1)
in_circle = dist <= 1

pts_in_circle = np.count_nonzero(in_circle)
pi = area * (pts_in_circle / N)

# plot results
plt.scatter(pts[in_circle,0], pts[in_circle,1],
            marker=',', edgecolor='k', s=1)
plt.scatter(pts[~in_circle,0], pts[~in_circle,1],
            marker=',', edgecolor='r', s=1)
plt.axis('equal')

print('mean pi(N={})= {:.4f}'.format(N, pi))
print('err  pi(N={})= {:.4f}'.format(N, np.pi-pi))

def create_uniform_particles(x_range, y_range, hdg_range, N):
    particles = np.empty((N, 3))
    particles[:, 0] = uniform(x_range[0], x_range[1], size=N)
    particles[:, 1] = uniform(y_range[0], y_range[1], size=N)
    particles[:, 2] = uniform(hdg_range[0], hdg_range[1], size=N)
    particles[:, 2] %= 2 * np.pi
    return particles

def create_gaussian_particles(mean, std, N):
    particles = np.empty((N, 3))
    particles[:, 0] = mean[0] + (randn(N) * std[0])
    particles[:, 1] = mean[1] + (randn(N) * std[1])
    particles[:, 2] = mean[2] + (randn(N) * std[2])
    particles[:, 2] %= 2 * np.pi
    return particles

def run_pf1(N, iters=18, sensor_std_err=0.1,
            do_plot=True, plot_particles=False,
            xlim=(0, 20), ylim=(0, 20),
            initial_x=None):
    landmarks = np.array([[-1, 2], [5, 10], [12,14], [18,21]])
    NL = len(landmarks)

    plt.figure()

    # create particles and weights
    if initial_x is not None:
        particles = create_gaussian_particles(
            mean=initial_x, std=(5, 5, np.pi/4), N=N)
    else:
        particles = create_uniform_particles((0,20), (0,20), (0, 6.28), N)
    weights = np.zeros(N)

    if plot_particles:
        alpha = .20
        if N > 5000:
            alpha *= np.sqrt(5000)/np.sqrt(N)
        plt.scatter(particles[:, 0], particles[:, 1],
                    alpha=alpha, color='g')

    xs = []
    robot_pos = np.array([0., 0.])
    for x in range(iters):
        robot_pos += (1, 1)

        # distance from robot to each landmark
        zs = (norm(landmarks - robot_pos, axis=1) +
              (randn(NL) * sensor_std_err))

        # move diagonally forward to (x+1, x+1)
        predict(particles, u=(0.00, 1.414), std=(.2, .05))

        # incorporate measurements
        update(particles, weights, z=zs, R=sensor_std_err,
               landmarks=landmarks)

        # resample if too few effective particles
        if neff(weights) < N/2:
            indexes = systematic_resample(weights)
            resample_from_index(particles, weights, indexes)

        mu, var = estimate(particles, weights)
        xs.append(mu)

        if plot_particles:
            plt.scatter(particles[:, 0], particles[:, 1],
                        color='k', marker=',', s=1)
        p1 = plt.scatter(robot_pos[0], robot_pos[1], marker='+',
                         color='k', s=180, lw=3)
        p2 = plt.scatter(mu[0], mu[1], marker='s', color='r')

    xs = np.array(xs)
    #plt.plot(xs[:, 0], xs[:, 1])
    plt.legend([p1, p2], ['Actual', 'PF'], loc=4, numpoints=1)
    plt.xlim(*xlim)
    plt.ylim(*ylim)
    print('final position error, variance:\n\t', mu - np.array([iters, iters]), var)
    plt.show()

from numpy.random import seed
seed(2)
run_pf1(N=5000, plot_particles=False)
