GT-IEEE-Robotics/2018/(commit log)

2017-06-08 simple motor controller
2017-07-08 old motor tests
2017-09-07 kicad tutorial
    [555.kicad_pcb, 555.sch]
2017-09-29 moved beaglebonecopypasta.cpp to app_note.cpp and added doxygen documentation & inital adaptations from mbed to linx. still need to change i2c class/function calls
2017-10-01 working motor test with uno
2017-11-02 added my old vl6180 time of flight distance sensor library and multiple qr code reader in case it's helpful to people
2017-11-06 clean up and organization
    [555.kicad_pcb, 555.sch]
2017-11-10 added motor cape files from KiCAD to repo
    [MotorCape.kicad_pcb, MotorCape.sch]
2017-11-10 Updating MotorController Code
2017-11-16 Worked on wiring motor cape connections.
    [MotorCape.sch]
2017-11-17 Changes made during meeting
    [MotorCape.sch]
2018-01-26 updated electrical connections. need to finish connectors on schematic.
    [MotorCape.sch]
2018-01-26 updated labels
    [MotorCape.sch]
2018-01-26 added level shifters and due and pi and labels
    [MotorCape.sch, level_shifters.sch]
2018-01-27 fixed drc errors, added serial comm between pi & due, now just need to choose power connector & fuse
    [MotorCape.sch, level_shifters.sch]
2018-02-16 added pi ICD
    [Bill Of Materials (what's on the robot so far) - Spreadsheet.xlsx, Pi_InterfaceControlDocument.xlsx]
2018-02-16 arduino umm due footprint hahahah youre adding the um haha
    [MotorCape.sch, level_shifters.sch]
2018-02-16 Removes KalmanFilter.py and replaces with IIR filter
2018-02-16 Finished Filter. Will update docs soon.
2018-02-16 trying to add xcel for bom
    [Bill Of Materials (what's on the robot so far) - Spreadsheet.xlsx, MotorCape.kicad_pcb, MotorCape.sch, level_shifters.sch]
2018-02-17 Moving changes from Sensor.py to controller.org and adding documentation.
2018-02-23 added ICD for pi and arduino
    [Arduino_ExternalConnections.xlsx, Pi_ExternalConnections.xlsx, Pi_InterfaceControlDocument.xlsx]
2018-02-23 added column for used connections/signals in IMU
    [Pi_ExternalConnections.xlsx]
2018-02-23 Added tutorial testing code for IMU
2018-02-23 worked more on motor cape
    [Arduino_ExternalConnections.ods, MotorCape.sch, level_shifters.sch]
2018-02-23 modified links on connection diagram
    [Arduino_ExternalConnections.ods, Arduino_ExternalConnections.xlsx]
2018-02-23 organized and cleaned up connections document. just need 3 more connectors for the arduino shield
    [Arduino_ExternalConnections.ods, Arduino_ExternalConnections.xlsx, Pi_ExternalConnections.xlsx]
2018-02-24 pi and arduino connector choice completed except battery connector
    [Arduino_ExternalConnections.xlsx, Pi_ExternalConnections.xlsx]
2018-02-24 finished all connectors. now to do schematic and footprint association
    [Arduino_ExternalConnections.xlsx]
2018-03-01 starting pi cape schematic
    [Arduino_ExternalConnections.xlsx, PI_Cape.kicad_pcb, PI_Cape.sch, Pi_ExternalConnections.xlsx]
2018-03-01 updated Pi and Arduino external connection. Finished base Pi schematic
    [Arduino_ExternalConnections.xlsx, PI_Cape.sch, Pi_ExternalConnections.xlsx]
2018-03-02 added gud stuff
    [MotorCape.sch]
2018-03-08 moved imu from pi to arduino on excel sheets
    [Arduino_ExternalConnections.xlsx, Pi_ExternalConnections.xlsx]
2018-03-16 not sure if i updated arduino connections recently but it said it changed
    [Arduino_ExternalConnections.xlsx]
2018-03-16 pushing aldriges changes to arduino board
    [MotorCape.sch]
2018-03-16 finished updates on pi schematic, working on footprints next
    [MotorCape.sch, PI_Cape.sch, Pi_ExternalConnections.xlsx, i2c0.sch, i2c0_sensors.sch]
2018-03-20 finished footprints on Pi cape. onto layouts
    [Arduino_ExternalConnections.xlsx, PI_Cape.sch, Pi_ExternalConnections.xlsx, i2c0.sch, i2c0_sensors.sch]
2018-03-20 added Jon's IMU code to OnTheArduino and shuffled folders
2018-03-21 updated pi cape to have 7-seg and spaced components in layout
    [PI_Cape.kicad_pcb, PI_Cape.sch, i2c0.sch]
2018-03-21 added preliminary comments on mecanum wheel movement vectors
2018-03-22 copies of both github & arduino are there. i'll merge them when i get home
2018-03-29 added distance sensor code
2018-03-30 added newest rules 3.3-1 stuff
    [MotorCape.kicad_pcb, MotorCape.sch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]
2018-03-30 Added basic implementation of movement PID on heading
2018-04-04 initialized shell for relative heading for indoors
    [MotorCape.kicad_pcb]
2018-04-05 updated sensor code
2018-04-05 moved into init functions (dist sensors)
2018-04-05 fixed samarthya thing class bus 1
    [VL53L0X_bus1.py]
2018-04-06 sensor stuff
2018-04-06 sensors pls
2018-04-06 importing one sensor lib at a time
2018-04-07 turned motor cape hiercichal, updated connector footprints to have latch, updated bettery connector, and did initial spacing on layout
    [Arduino_ExternalConnections.xlsx, MotorCape.kicad_pcb, MotorCape.sch, MotorsAndController.sch, level_shifters.sch]
2018-04-07 trying to lay-out things. lots of via's, this could be a bit messy
    [MotorCape.kicad_pcb, MotorCape.sch, MotorsAndController.sch]
2018-04-08 pushing changes while routing. still not done yet
    [MotorCape.kicad_pcb, MotorCape.sch, MotorsAndController.sch]
2018-04-08 did some PID tuning
2018-04-09 pushing latest motor controller layout changes
    [MotorCape.kicad_pcb, MotorCape.sch, MotorsAndController.sch, Pi_ExternalConnections.xlsx]
2018-04-09 did some testing with i2c
2018-04-09 distance sensor library modification
2018-04-09 added distance sensor lib mods
2018-04-10 finished the hierarchicalalala motor cape board
    [MotorCape-B.Cu.gbl, MotorCape-B.Mask.gbs, MotorCape-B.SilkS.gbo, MotorCape-Edge.Cuts.gm1, MotorCape-F.Cu.gtl, MotorCape-F.Mask.gts, MotorCape-F.SilkS.gto, MotorCape.drl]
2018-04-10 starting to work on dist sensor stuff
    [MotorCape-B.Cu.gbl, MotorCape-B.Mask.gbs, MotorCape-B.SilkS.gbo, MotorCape-Edge.Cuts.gm1, MotorCape-F.Cu.gtl, MotorCape-F.Mask.gts, MotorCape-F.SilkS.gto, MotorCape.drl]
2018-04-10 added default param for bus_num in i2c_read
2018-04-10 fixed build errors for i2c_read
    [vl53l0x_platform.c]
2018-04-10 fixed py indentation error
    [VL53L0X.py]
2018-04-10 implemented bus_num into c lib's sensor structs
2018-04-12 arduino imu updates
2018-04-13 trying to fix pid
    [ArdComm.py, moveStraight.ino.ino]
2018-04-14 added imu heading correction code
    [ArdComm.py, headingReset.py, moveStraight.ino.ino]
2018-04-14 starting particle filter code
2018-04-14 added particle filter code
2018-04-17 removed extra python code, added functions to make arduino code shorter
    [letsDrive.py, moveStraight.ino.ino]
2018-04-19 added files after the wlan0 broke
    [ArdComm.py, headingReset.py, moveStraightAngV.ino.ino, testRight.py]
2018-04-19 encoder stuff
2018-04-19 modified encoder test
2018-04-19 fixed encoder.ino
2018-04-19 made a bombass imu class
2018-04-19 cleaning up gyro theta class
2018-04-19 fixed the imu class
    [sketch_apr19a.ino]
2018-04-19 kicad stuff
    [PI_Cape.kicad_pcb]
2018-04-19 fixed pid code
2018-04-19 gyro stuff
2018-04-20 added file to gen sensor readings
2018-04-20 added sensor reading files
2018-04-20 setting up full system test folder on arduino
2018-04-20 successfully tested all encoders on motor controller board
    [MotorCape.kicad_pcb]
2018-04-20 added new sensor readings
2018-04-21 pushing stuff for arduino
2018-04-21 Velocity PID wheel drive initial upload
2018-04-21 updated pin locations
2018-04-21 added servo
2018-04-21 flag motor test
